UVAVIVA/CLIMAORO/README.md

# CLIMAORO

**Sistema di termoregolazione a zone open source**

CLIMAORO è un sistema completo per il controllo centralizzato del riscaldamento e raffrescamento in edifici con impianto a pavimento e pompa di calore, ma adattabile a tutte le tipologie. Progettato per essere replicabile, modulare e professionale.

---

## 🌐 Sito web

[https://UVAVIVA.github.io/CLIMAORO/](https://UVAVIVA.github.io/CLIMAORO/)

**🇬🇧 English version:** [https://UVAVIVA.github.io/CLIMAOROen/](https://UVAVIVA.github.io/CLIMAOROen/)

---

## 📖 Cos'è CLIMAORO

CLIMAORO è un sistema che:

- **Ottimizza la pompa di calore** riducendo i cicli brevi di accensione
- **Gestisce più zone** in modo centralizzato con logica a pesi e soglie
- **Comunica senza WiFi** grazie a ESP-NOW (fallback)
- **Si affianca all'impianto tradizionale** senza sostituirlo
- **Costa meno di 15€ a termostato** (contro i 100-250€ dei sistemi commerciali)

---

## 📷 Termostati

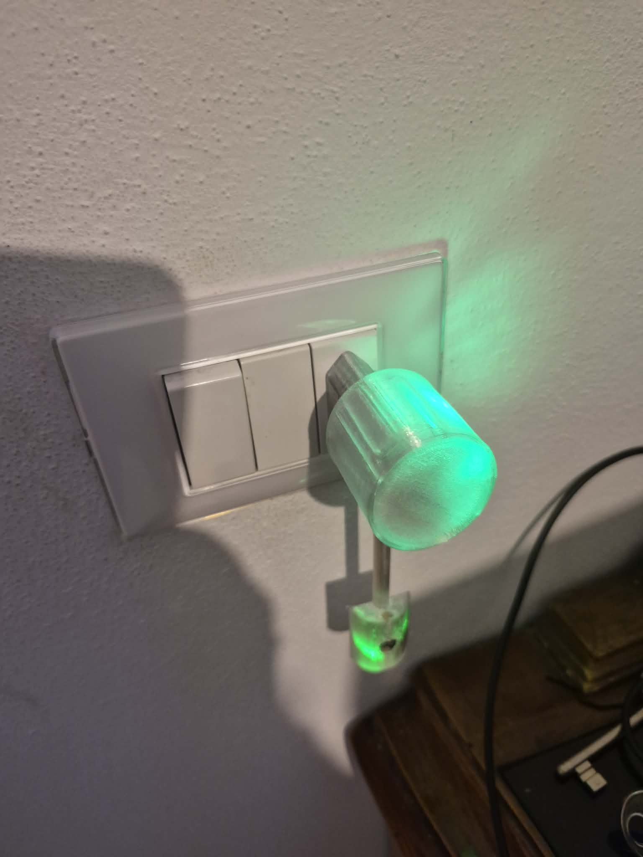
[picture p1: images/termostati/1.jpg]
Termostato 1
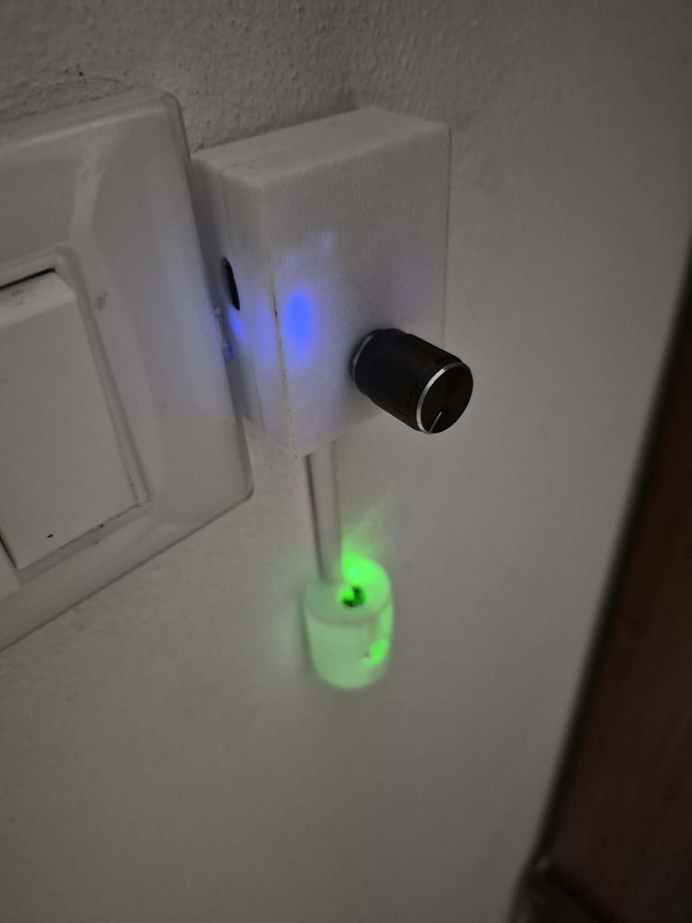
[picture p2: images/termostati/2.jpg]
Termostato 2
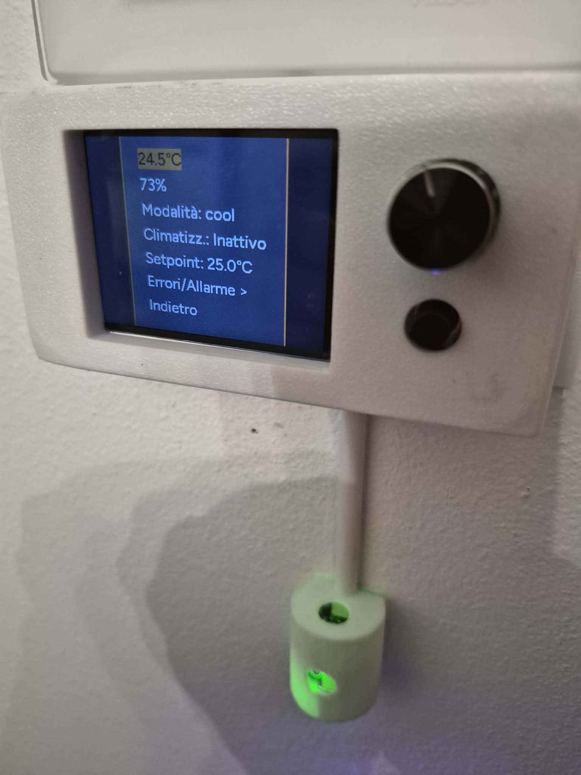
[picture p3: images/termostati/3.jpg]
Termostato 3
  

---

## 🔧 Stato del progetto

| Funzionalità | Stato |
|---|---|
| Raffrescamento estivo | ✅ In produzione |
| Deumidificatori | ✅ Integrati |
| Fotovoltaico | ✅ Integrato |
| Logica invernale | 🔄 Pronta, in attesa di test |
| Documentazione | 📝 In costruzione |

---

## 🔌 Termostato mobile

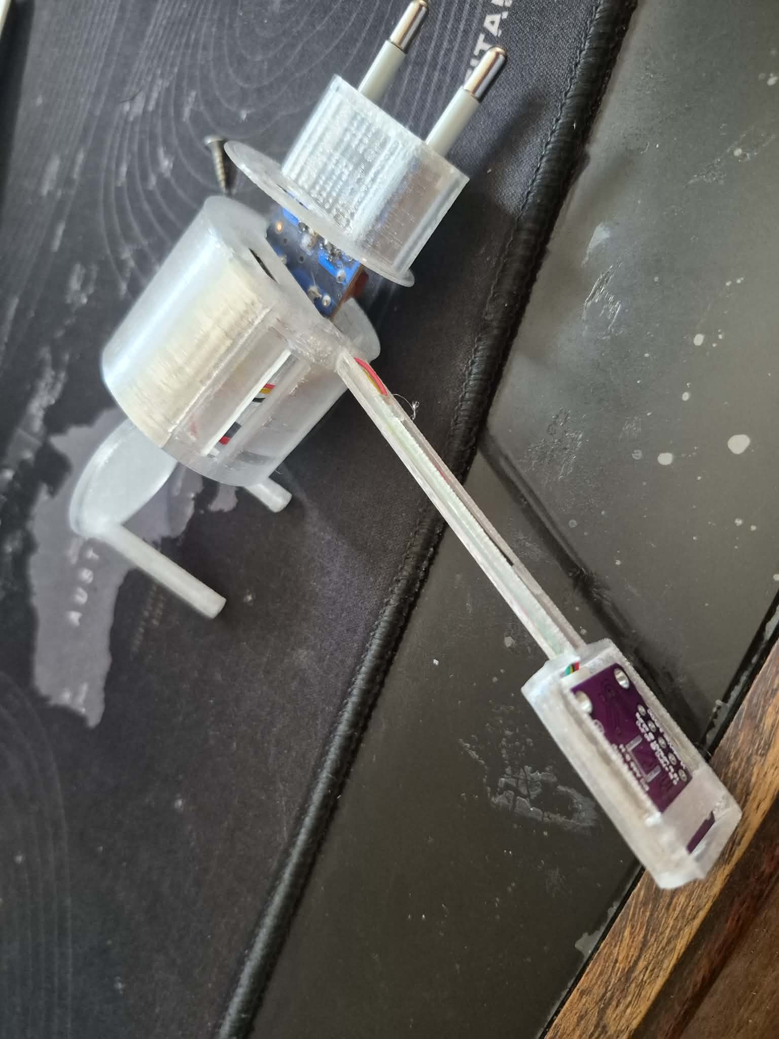
[picture p4: images/termostato-mobile/1.jpg]
Termostato mobile 1
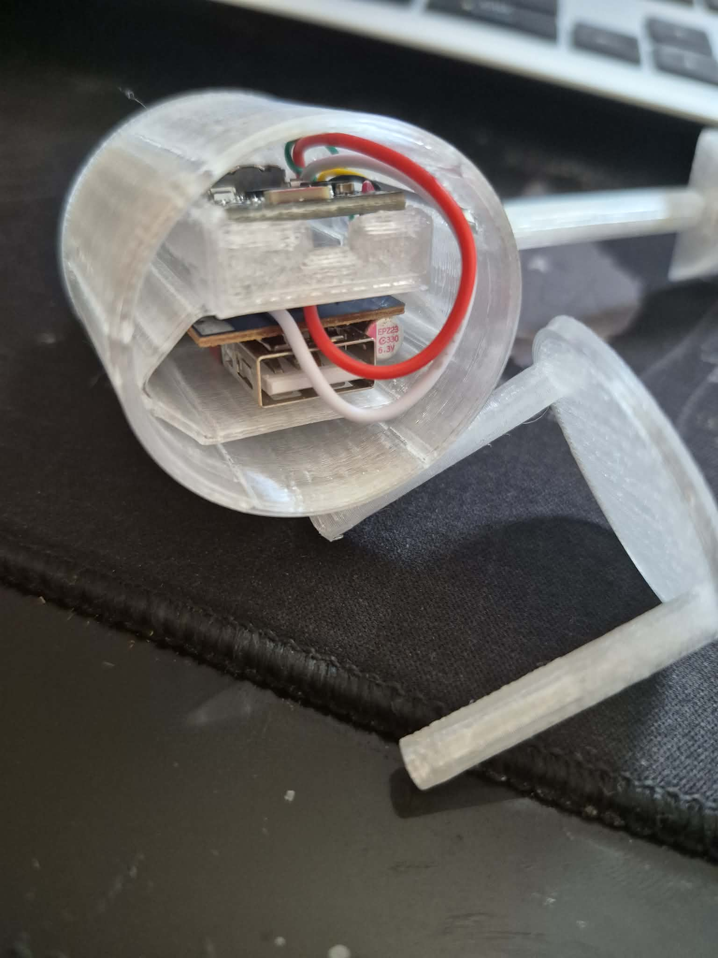
[picture p5: images/termostato-mobile/2.jpg]
Termostato mobile 2
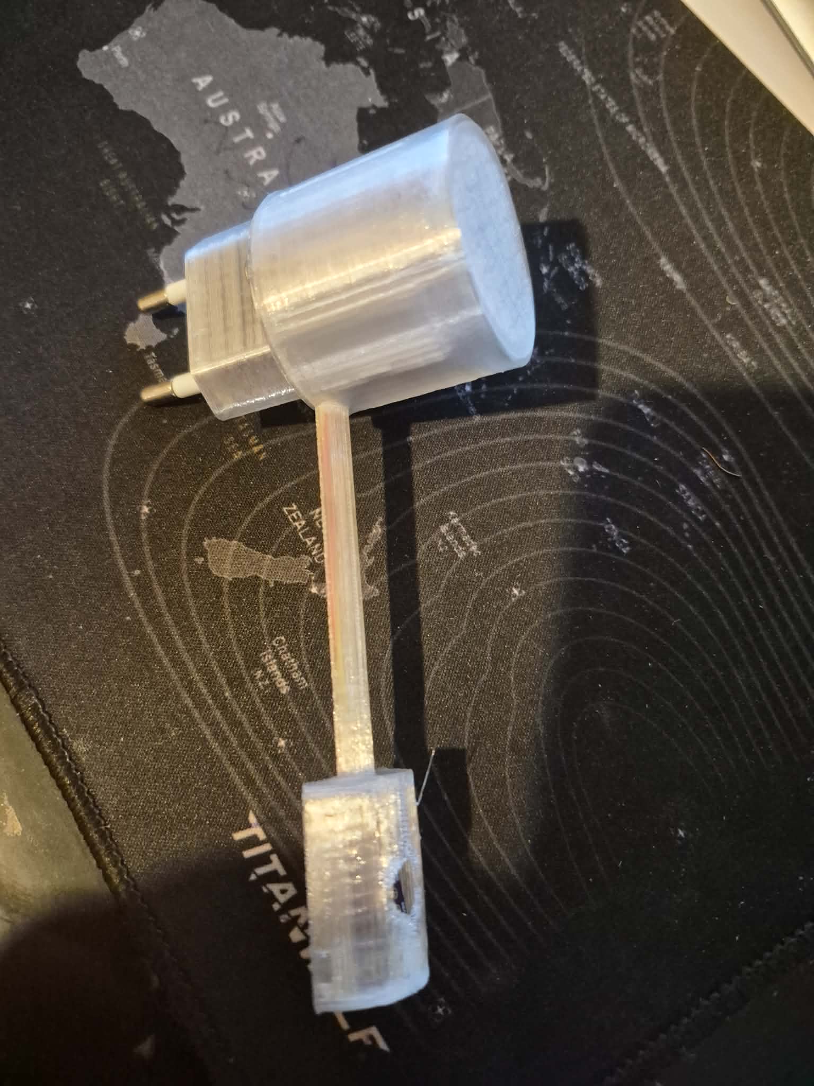
[picture p6: images/termostato-mobile/3.jpg]
Termostato mobile 3
  

**Part list:**

- [Scheda ESP32-C6](https://it.aliexpress.com/item/1005007676682081.html)
- [Sensore di temperatura e umidità (SHT4x)](https://it.aliexpress.com/item/1005009954170157.html)
- [Caricatore / alimentazione](https://it.aliexpress.com/item/1005008268805480.html)

**Case stampa 3D termostato mobile:**

- [termostato-ovale-19-c6.3mf](docs/files/termostato-ovale-19-c6.3mf)
- Materiale consigliato: **PETG**
- Nota: il file può essere aperto solo con **OrcaSlicer** o **Flash Studio**

**📋 Tutorial montaggio:**

- [Guida completa al montaggio del termostato](docs/montaggio.md)
- [Sito web - pagina Montaggio](https://UVAVIVA.github.io/CLIMAORO/montaggio/)

**Configurazione per la compilazione:**

- [Config principale termostato - esempio pronto da copiare (italiano)](https://github.com/UVAVIVA/climaoro-components/blob/main/CLIMAORO_Termostato-Esempio.yaml)

---

## 🧩 Componenti principali

| Componente | Descrizione |
|---|---|
| **Termostati** | Dispositivi ESP32 (S3/C6/C3) con sensori, LED, e diverse modalità di installazione (presa elettrica, scatola 503) |
| **Collettore** | Unità centrale con relè per valvole e circolatore, con feedback optoisolato |
| **Logica centralizzata** | Controllo intelligente che decide quando accendere la pompa in base alla domanda aggregata |

---

## 🎛️ Termostato encoder integrato con 503

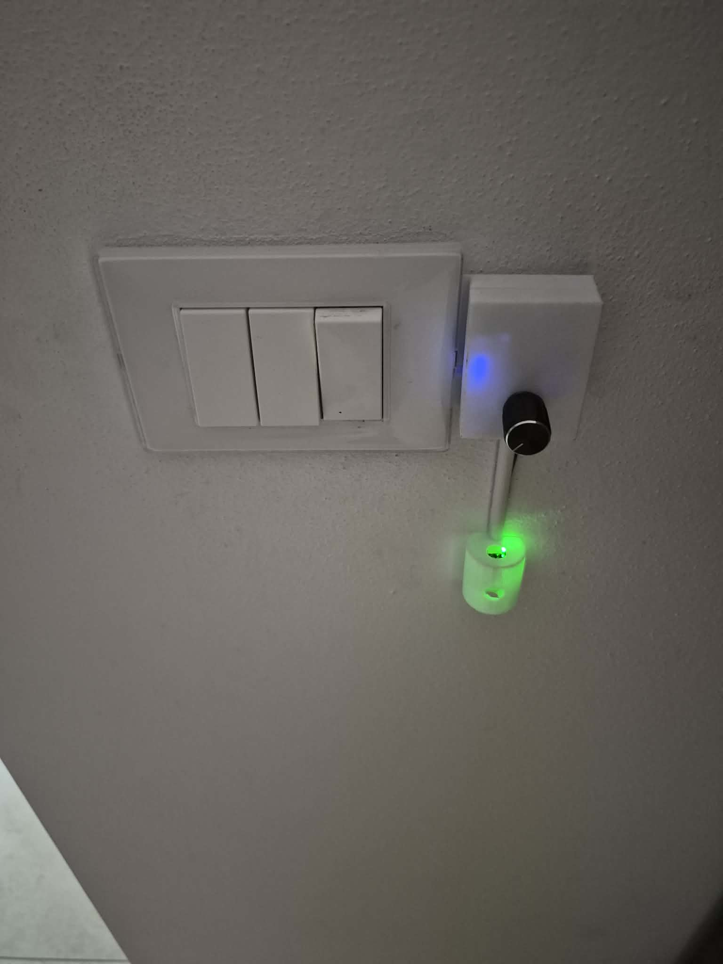
[picture p7: images/termostato-encoder-503/1.jpg]
Termostato encoder 503 1
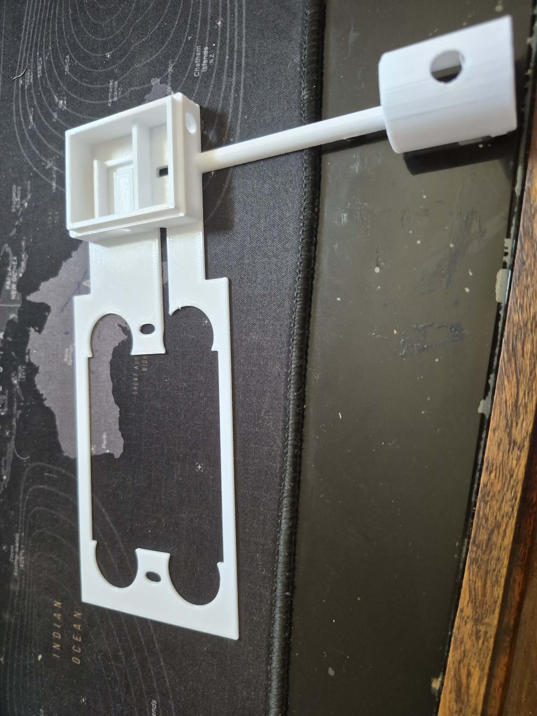
[picture p8: images/termostato-encoder-503/2.jpg]
Termostato encoder 503 2
 

**Part list:**

- [Scheda ESP32-S3](https://it.aliexpress.com/item/1005007171129437.html)
- [Encoder rotativo](https://it.aliexpress.com/item/1005012374134834.html)
- [Display](https://it.aliexpress.com/item/1005009260256313.html)

---

## 🤝 CERCO COLLABORAZIONI

Questo progetto è aperto a contributi. Cerco persone con competenze specifiche per portare avanti lo sviluppo e migliorare il sistema.

### Aree di interesse

| Area | Competenze cercate |
|---|---|
| **Hardware** | Progettazione PCB, ottimizzazione componenti, miglioramento affidabilità, riduzione costi |
| **Programmazione** | Firmware ESPHome, logica di controllo, integrazione Home Assistant, sviluppo interfacce |
| **Documentazione** | Guide installazione, manuali tecnici, traduzioni |
| **Test** | Test su altri impianti, in contesti diversi, con configurazioni differenti |
| **Sviluppo app** | Applicazione per generare configurazioni senza toccare codice |

### Chi cerco

Persone che sappiano già muoversi in questi ambiti. Il progetto ha raggiunto un livello di complessità che richiede **esperienza consolidata**: chi contribuisce deve saper leggere e modificare codice, comprendere schemi elettrici, o saper documentare in modo chiaro e preciso.

Non è necessario avere esperienza in tutti gli ambiti, ma è importante avere **competenze solide in almeno uno di essi**.

### Come contribuire

1. Esplora il progetto su [GitHub](https://github.com/UVAVIVA/CLIMAORO)
2. Apri una **issue** per discutere le modifiche
3. Fai un **fork** del repository
4. Invia una **pull request**

📌 **Scopri di più:** [https://UVAVIVA.github.io/CLIMAORO/collabora/](https://UVAVIVA.github.io/CLIMAORO/collabora/)

---

## 🛠️ Collettore

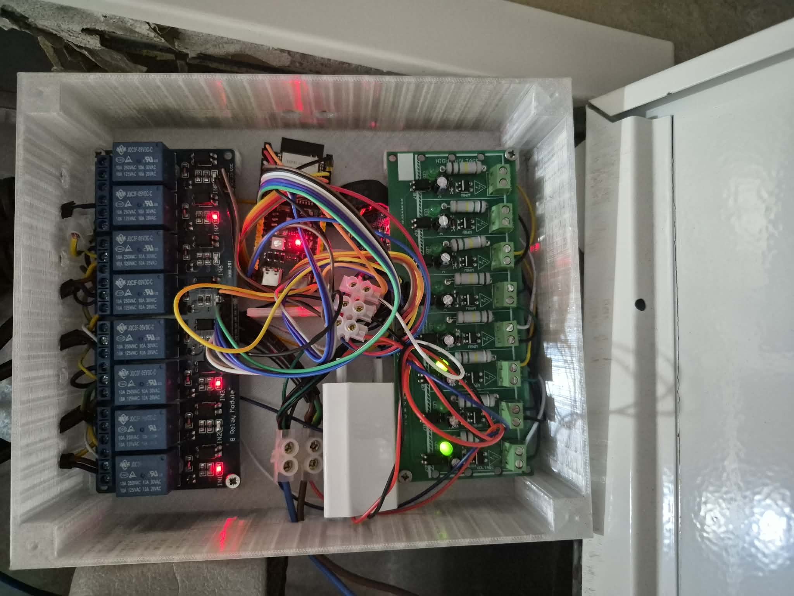
[picture p9: images/collettore/1.jpg]
Collettore 1
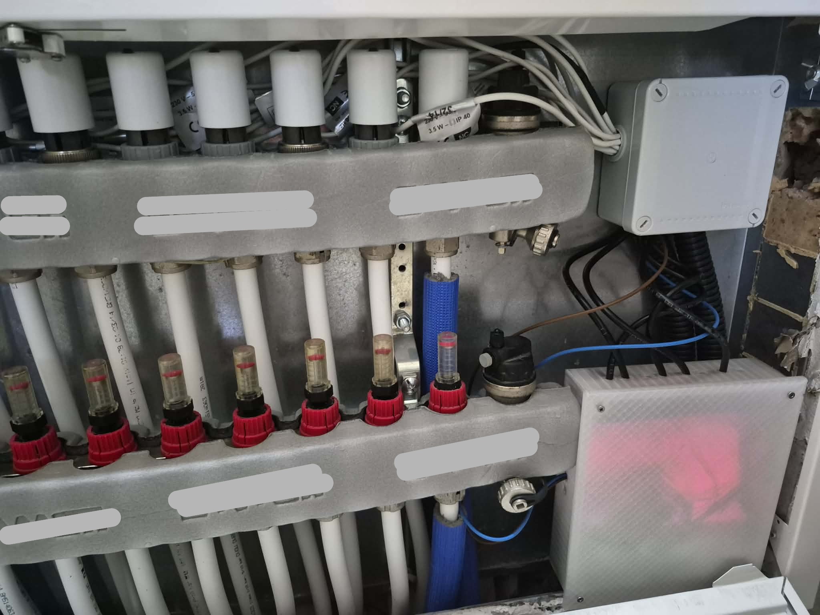
[picture p10: images/collettore/2.jpg]
Collettore 2
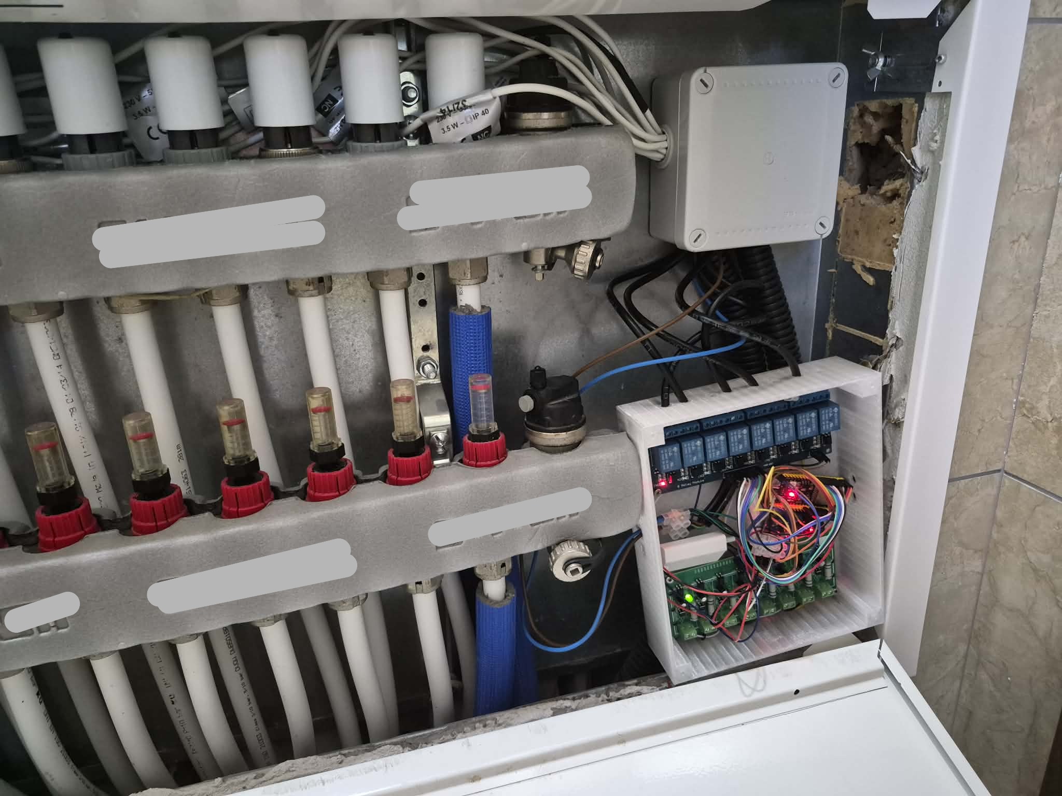
[picture p11: images/collettore/3.jpg]
Collettore 3
  

**Part list:**

- [Scheda ESP32-C6](https://it.aliexpress.com/item/1005006678253557.html)
- [Modulo relè (4+ canali)](https://it.aliexpress.com/item/1005007538301230.html)
- [Optoisolatori](https://it.aliexpress.com/item/1005009598584430.html)

**Configurazione per la compilazione:**

- [Config principale collettore - esempio pronto da copiare (italiano)](https://github.com/UVAVIVA/climaoro-components/blob/main/CLIMAORO_Collettore-Esempio.yaml)

**📋 Tutorial montaggio:**

- [Guida completa al montaggio del collettore](docs/collettore_tutorial.md)
- [Sito web - pagina Montaggio Collettore](https://UVAVIVA.github.io/CLIMAORO/collettore_tutorial/)

---

## 📜 Licenza e Responsabilità

**CLIMAORO © 2026 by UVAVIVA** · Licenza: **MIT con Condizione di Attribuzione**

**Termini**
- ✅ Attribuzione richiesta (nel codice e sui dispositivi commerciali)
- ✅ Uso commerciale permesso (con attribuzione)
- ✅ Modifiche e derivati permessi
- ✅ Uso, copia, distribuzione e vendita permessi

**Disclaimer**
Questo progetto è fornito **così com'è**, a scopo educativo e sperimentale.
- ⚠️ Non certificato per uso produttivo
- ⚠️ ⚡ **PERICOLO: gli interventi sull'impianto elettrico e termoidraulico devono essere eseguiti solo da personale qualificato**
- ⚠️ Nessuna garanzia di alcun tipo
- ⚠️ L'utente si assume ogni rischio

**Rispettare sempre le norme elettriche e di sicurezza locali.**

---

**Costruito con passione, dal nulla.**
