UVAVIVA/CLIMAORO/docs/collabora.md

# Collabora

## Cerco collaborazioni

Questo progetto è aperto a contributi. Cerco persone con competenze specifiche per portare avanti lo sviluppo e migliorare il sistema.

**Aree di interesse:**

- **Hardware:** progettazione PCB, ottimizzazione dei componenti, miglioramento dell'affidabilità, riduzione dei costi
- **Programmazione:** firmware ESPHome, logica di controllo, integrazione con Home Assistant, sviluppo di interfacce
- **Documentazione:** guide per l'installazione, manuali tecnici, traduzioni
- **Test:** test su altri impianti, in contesti diversi, con configurazioni differenti
- **Sviluppo app:** applicazione per generare configurazioni senza toccare codice

Cerco persone che sappiano già muoversi in questi ambiti. Il progetto ha raggiunto un livello di complessità che richiede esperienza consolidata: chi contribuisce deve saper leggere e modificare codice, comprendere schemi elettrici, o saper documentare in modo chiaro e preciso.

Non è necessario avere esperienza in tutti gli ambiti, ma è importante avere competenze solide in almeno uno di essi. Il progetto è strutturato e richiede contributi di qualità.

## Come contribuire

1. Esplora il progetto su GitHub
2. Apri una issue per discutere le modifiche
3. Fai un fork del repository
4. Invia una pull request

---

## 📜 Licenza e Responsabilità

**CLIMAORO © 2026 by UVAVIVA** · Licenza: **MIT con Condizione di Attribuzione**

**Termini**
- ✅ Attribuzione richiesta (nel codice e sui dispositivi commerciali)
- ✅ Uso commerciale permesso (con attribuzione)
- ✅ Modifiche e derivati permessi
- ✅ Uso, copia, distribuzione e vendita permessi

**Disclaimer**
Questo progetto è fornito **così com'è**, a scopo educativo e sperimentale.
- ⚠️ Non certificato per uso produttivo
- ⚠️ ⚡ **PERICOLO: gli interventi sull'impianto elettrico e termoidraulico devono essere eseguiti solo da personale qualificato**
- ⚠️ Nessuna garanzia di alcun tipo
- ⚠️ L'utente si assume ogni rischio

**Rispettare sempre le norme elettriche e di sicurezza locali.**
