UVAVIVA/CLIMAORO/docs/sistema.md

# Il sistema

## Come si inserisce nella casa

Questo sistema non sostituisce l'impianto tradizionale. Lo affianca.

L'impianto tradizionale continua a funzionare in parallelo. In caso di guasto del sistema smart, basta spegnerlo e l'impianto tradizionale riprende il controllo. Per persone non competenti: basta spegnere, niente da capire.

Questo è un vantaggio enorme rispetto ai sistemi commerciali chiusi.

Il sistema è nato per un impianto a pavimento con pompa di calore on/off, suddiviso in più zone, ma l'idea è applicabile anche ad altri sistemi: caloriferi tradizionali, sistemi misti, condizionatori d'aria. Qualsiasi sistema di climatizzazione che possa essere comandato da un termostato.

## La logica di controllo

Il cuore del sistema è una logica che decide collettivamente quando accendere la pompa di calore.

Ogni zona ha un peso (importanza: superficie, dispersione, priorità). Ogni zona ha dei delta: una temperatura di guardia e una temperatura di lavoro, separate per giorno e notte. Un sistema di controllo centralizzato calcola la domanda aggregata ogni minuto. Se la domanda supera una soglia, la pompa si accende. Se una zona è già in riscaldamento, ha priorità.

Il risultato è che la pompa di calore non si accende per una singola zona piccola, ma solo quando la richiesta complessiva è sufficiente. I cicli sono più lunghi e meno frequenti. Meno consumi, meno usura, più comfort.

## Perché questo progetto è diverso

Questo sistema affronta il problema nella sua globalità, molto più di molte soluzioni attualmente sul mercato. Non è un semplice termostato WiFi, non è un sistema chiuso, non è un prototipo amatoriale. È un sistema completo, replicabile, strutturato, con un'impronta professionale.

**Precisazione:** Questo progetto nasce per passione, non per fini di lucro. Non ho interesse a commercializzarlo direttamente né a trarne profitto. Tuttavia, sono ben consapevole che, per la sua completezza e robustezza, potrebbe prestarsi a usi professionali o commerciali. Se qualcuno volesse utilizzarlo in questo senso — per un impianto condominiale, un edificio pubblico, una struttura ricettiva, una casa di nuova costruzione — è libero di farlo. Il progetto è documentato, modulare, flessibile, e la licenza open source lo permette.
