UVAVIVA/CLIMAORO/docs/stato.md

# Stato e sviluppi

## Stato attuale

Il raffrescamento estivo è in produzione da mesi, sedici ore al giorno. I deumidificatori sono integrati e il sistema è già collegato al fotovoltaico: la produzione solare viene sfruttata per gestire la deumidificazione, ottimizzando i consumi quando l'energia è disponibile. Inoltre, un controllo dell'umidità ambientale impedisce il raggiungimento del punto di rugiada, proteggendo l'impianto e la casa da condensa e muffe.

I termostati funzionano. Il collettore comanda le valvole. La logica per l'inverno è scritta e pronta per essere testata.

Ci sono aree in miglioramento: la stabilità della comunicazione in presenza di interferenze, la calibrazione dei pesi e delle soglie. Ma il sistema c'è, funziona, e si evolve giorno per giorno.

## Sviluppi futuri

Ci sono idee per il futuro: un'app per generare la configurazione senza toccare codice, un test comparativo tra logica centralizzata e logica separata. Ma al momento la priorità sono i termostati e il collettore. Il resto verrà dopo, se e quando avrà senso.
