UVAVIVA/CLIMAORO/docs/files/termostato-ovale-19-c6.3mf

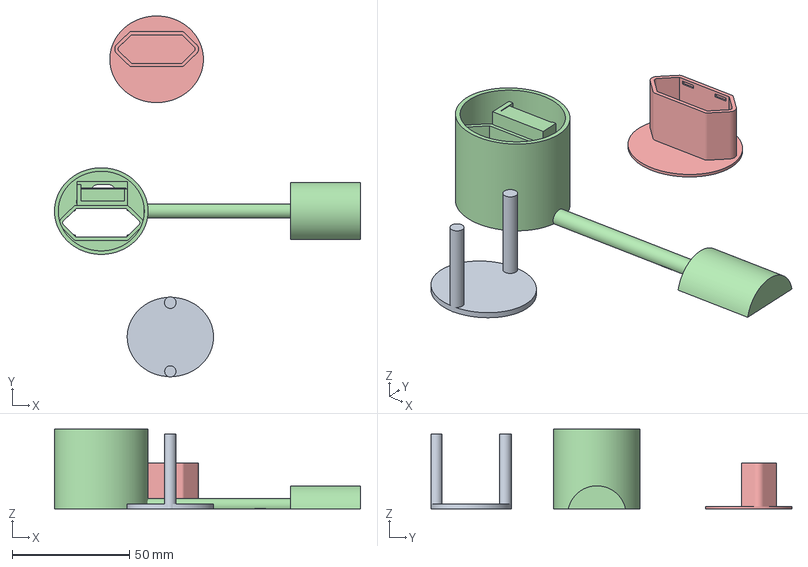
[picture p12: CAD file, 2026-08-04]
docs/files/termostato-ovale-19-c6.3mf
130.8 x 154.3 x 34.0 mm
Assembly x 2
