UVAVIVA/CLIMAORO/(commit log)

2026-08-03 Traduzione completa in inglese di tutte le pagine
2026-08-03 Aggiunto file di verifica Google Search Console
2026-08-04 Ruotate foto di 90 gradi antiorario
2026-08-04 Scambiati gruppi foto mobile/encoder nel README e aggiunta part list AliExpress
2026-08-04 Corretti link part list: caricatore/C6 invertiti e rotazione S3/encoder/display
2026-08-04 Aggiunte foto collettore e termostati in hardware.md, case stampa 3D termostato mobile (PETG) e rebuild sito
    [termostato-ovale-19-c6.3mf]
2026-08-04 Aggiunti link diretti ai file di configurazione climaoro-components
2026-08-06 Rimuove output di build (site/) dal tracciamento; aggiunge .gitignore
    [termostato-ovale-19-c6.3mf]
2026-08-06 Passa alla licenza MIT con Condizione di Attribuzione (codice + dispositivi commerciali)
2026-08-16 Foto affiancate nel tutorial su GitHub; warning sicurezza 230V più incisivo
2026-08-16 Tono warning sicurezza 230V più sobrio e informativo
2026-08-16 Clausola responsabilità: chi monta si assume la responsabilità, prodotto artigianale senza garanzie
2026-08-17 Fix image paths and add schematic images to docs
